InDevBrian/index/Media/Tow_Hitch_Receiver_Report.pdf

# MENG 293 Final Project Technical Document

## BMW E28 Chassis Tow Hitch Receiver

Brian Gill
C0503517

# Table of Contents

Introduction
Purpose
Problem Definition

Summary

Methodology
Measurements Values
Calculated Values
Assumptions
Neglected Factors

Establishing a Baseline
Chassis Strength Minimums
Comparison of Calculated and Measured Values Vehicle Maneuverability Limits

Design
Description
Materials Used
Safety
Model Images and Drawings

Calculations
Deceleration of performance model E28 M5 Deceleration and forces from bumper impact requirements Maximum lateral acceleration
Center of gravity of the chassis
Bumper impact reaction forces
Equations governing hitch forces
Geometry analysis of the bumper shock flange and stress calculations Geometry analysis of the receiver mounting flanges
Stresses due to fully loaded receiver reactions

Future Work

Conclusion

Appendix

Sources

## Introduction

Purpose

This project is meant to promote renewable behaviours through repair and improvement over discard and replacement. To meet this goal, this document describes the development of a solution to enable the BMW e28 chassis to tow trailered loads with a standard ball hitch.

Problem Definition

Original e28 chassis do not come equipped with tow hitch receivers. BMW has previously offered a solution for their European vehicles with a tow mass rating of 1800kg [7]; however, this product is long since discontinued, and was quite intrusive into the trunk area with large bolts and plates to clamp down on the sheet metal, supports stretching from under the taillamps to the tops of the rear strut towers, and a long, complicated install procedure. There are no current aftermarket solutions for these cars. The problem to solve is offering a simple tow hitch receiver that does not modify the chassis and matches the original capacity.

## Summary

This document describes the development of a trailer hitch receiver for the BMW e28 chassis. In the design process analysis was done to determine a minimum strength of the chassis where the receiver is to mount. To determine the minimum strength, calculations were done based on bumper safety standards applicable to this vehicle. Comparing the maximum stresses calculated from towing at rated capacity versus the minimum stresses based on required impact ratings, it was found that the chassis cannot be damaged through towing at maximum capacity. The maximum stresses calculated are based on a handful of assumptions and neglected factors which aim to exaggerate the calculated values to add a layer of safety for the design. Although the chassis won’t be damaged by an 1800kg unbraked load it is not recommended as the maximum deceleration is significantly decreased and could be dangerous in the event of an emergency stop.

## Methodology

Measured Values

Several values needed to be measured for both calculations and design decisions. For the receiver to mate to the existing chassis and fit between the exhaust and bottom of the bumper, the bumper shock absorber flange profile, spacing, and compression distance were measured. To estimate the frictional coefficient of tires, acceleration values at maximum braking were measured. A 3D scan of the chassis was taken to test fit the model in software prior to any assembly.

Calculated Values

The maximum normal acceleration withstood by tires was calculated by recording the velocity where grip would turn to slip through a corner and measuring the radius of the corner at that time. The average deceleration in impact tests was calculated using the displacement of the bumper shock absorbers, and the speed of the impact test. The centre of gravity of the e28 chassis was calculated using the weight distribution, and wheelbase of the car. Equations were developed to determine the maximum straight-line loads on the hitch receiver based on tow mass, road grade, and tire friction limits.

Assumptions

To solve some of the equations developed, assumptions had to be made. The intent of the assumptions made is to increase the estimated forces on the receiver, decrease the chassis rated minimum stresses, or to simplify calculations due to variables that frequently change. The following assumptions were made and held consistent throughout the calculations.

Trailered load is 1800kg mass.
Tongue carries 10% of trailered weight.
Trailer axle to tongue length is 2.45m.
Trailered load is slender and has negligible aerodynamic drag even at high speeds.
Trailered center of mass, tow ball, and vehicle centre of mass are all 0.6m above ground level. Tires have a static frictional coefficient of 0.80.
Trailer axle has a static rolling resistance coefficient of 0.015 [1].
Unpowered, non-braking chassis axles have a static rolling resistance of 0.015 [1]. Deceleration during a crash tests is constant.

Neglected Factors

The purpose of neglecting the following factors is to simplify the calculations and bias them towards higher stresses throughout the system. Neglecting the slight increase of tire friction from wheel slip implies that when towing a load, the driver will act responsibly without slipping any tires.

Aerodynamic drag of the vehicle.
Vehicle weight transfer from brake dive and acceleration squat.
Vehicle weight transfer from transverse loading.
Increased tire friction between 5%- and 20%-wheel slip.
Brake bias and force limits of the braking system.
Acceleration limits from the engine.

## Establishing a Baseline

Chassis and Receiver Strength Minimums

Analysis of the chassis has been done based on the test procedures and requirements for bumpers outlined in [5]. Based on Table 1 and the fact that the North American e28 chassis remained unchanged through all its production starting model year 1981, the minimum bumper impact ratings can be summarized as the chassis remains undamaged following a 5 MPH straight forward front and rear impact or a 3 MPH impact at an angle of 60° from the centre line of the car. The claim to an undamaged chassis follows from a list of definitions written in [5].

The patent describing the rear bumper shock mechanism [2] describes different dimensions from what is measured on the vehicle; however the shape of graph 2 depicting load vs stroke tells us that there is a roughly linear relation between stroke distance and reaction force, which by extension would be seen as a linear increase of deceleration during a crash.

The original tow hitch receiver is commonly rated at 1800kg online [7], although a reputable source has yet to be found. For the European version of this vehicle, a sales brochure translated from Dutch using Duck Duck Go’s translator claims “Permissible trailer weight braked 1400 kg up to max. 12% incline, unbraked 500 kg (trailer weight increase possible, please contact your BMW dealer).” [6]. The mention of possible weight increase supports the claim of a maximum of 1800kg. For the calculations done, the assumption follows an 1800kg load without brakes.

Comparison of Calculated and Measured Values

To ensure the values used as the baseline in the calculations are reasonable, this is a comparison of calculated and measured values using data from multiple sources. In the following text g’s are used in reference to acceleration, 1 g is 9.81m/s²
, and coefficient before g can always be translated as the coefficient of friction between the tire and road surface. Maximum deceleration has been measured at 0.80 g’s in a test vehicle; the performance model e28 m5 manages an average of 0.97 g’s, (1) using data from info sheet 1. Readings from [1] summarize a technical document outlining requirements for braking system performance, of which the greatest deceleration value is 20 ft/s²
(0.62 g’s).
Historical data combined with a measurement from Screenshot 1 provides a lateral acceleration of 0.80 g’s (6). The test vehicle used measured lateral acceleration at 0.60 g’s. Given that [3] is using performance tires and an improved braking system, the slightly higher deceleration is logical.

Chassis Maneuverability Limitations

Every vehicle’s maneuverability is ultimately limited by the tires. Based on 0.80 g’s of acceleration for both straight line and lateral motion, the coefficient of static friction between the tires and the road surface can be
determined as 0.80. That is to say that in any position the net acceleration of the vehicle can not exceed 0.80 g’s. This limit decreases once the trailered load is considered, although the coefficient of friction for the driving vehicles tires does not change. The calculations done to determine the maximum loads present during trailering are in the scenario of perfect braking. Events of large forward and lateral acceleration would be considered irresponsible during towing and as such there are no calculations in this report covering those scenarios.

## Design

Description

The primary goal of the design is to enable users to safely tow any cargo up to 1800kg mass. Beyond reaching this target the design focuses on fixing some issues prevalent in the OEM offered solution from many years ago, these improvements are directed at not impacting the functionality of any safety equipment, not being an eyesore, and not protruding into the trunk area or modifying the chassis in any other way. Featured in the design is safety hoops for safety chains to be installed on, a wire run routing that forces a drip loop into the harness, and a large split to even out the reaction forces and stresses developed during towing. The design is on it’s third revision after the first major change. Future changes are limited to adjusting the split to further improve the load balancing and the designated failure point.

Materials

The goals of specifying materials for this design are primarily to reduce cost, and secondly to prevent corrosion. For all make parts designed the material is mild steel, this is because mild steel is easy to weld, cheap, and strong. All installation hardware should be stainless steel to prevent corrosion. The receiver should be powder coated to withstand the harsh conditions present during road travel.

Safety

For this receiver to have no interference with the original safety equipment, when installed without a tow ball the receiver must not protrude past the distance of an uncompressed bumper. There must be no way for a trailered load of 1800kg or less to damage the chassis. The electrical system to provide power for running, brake, and turn signal lamps must be fully sealed where it leaves the chassis, be properly sleeved to prevent abrasion, and have drip loops to ensure water does not collect in the connectors.

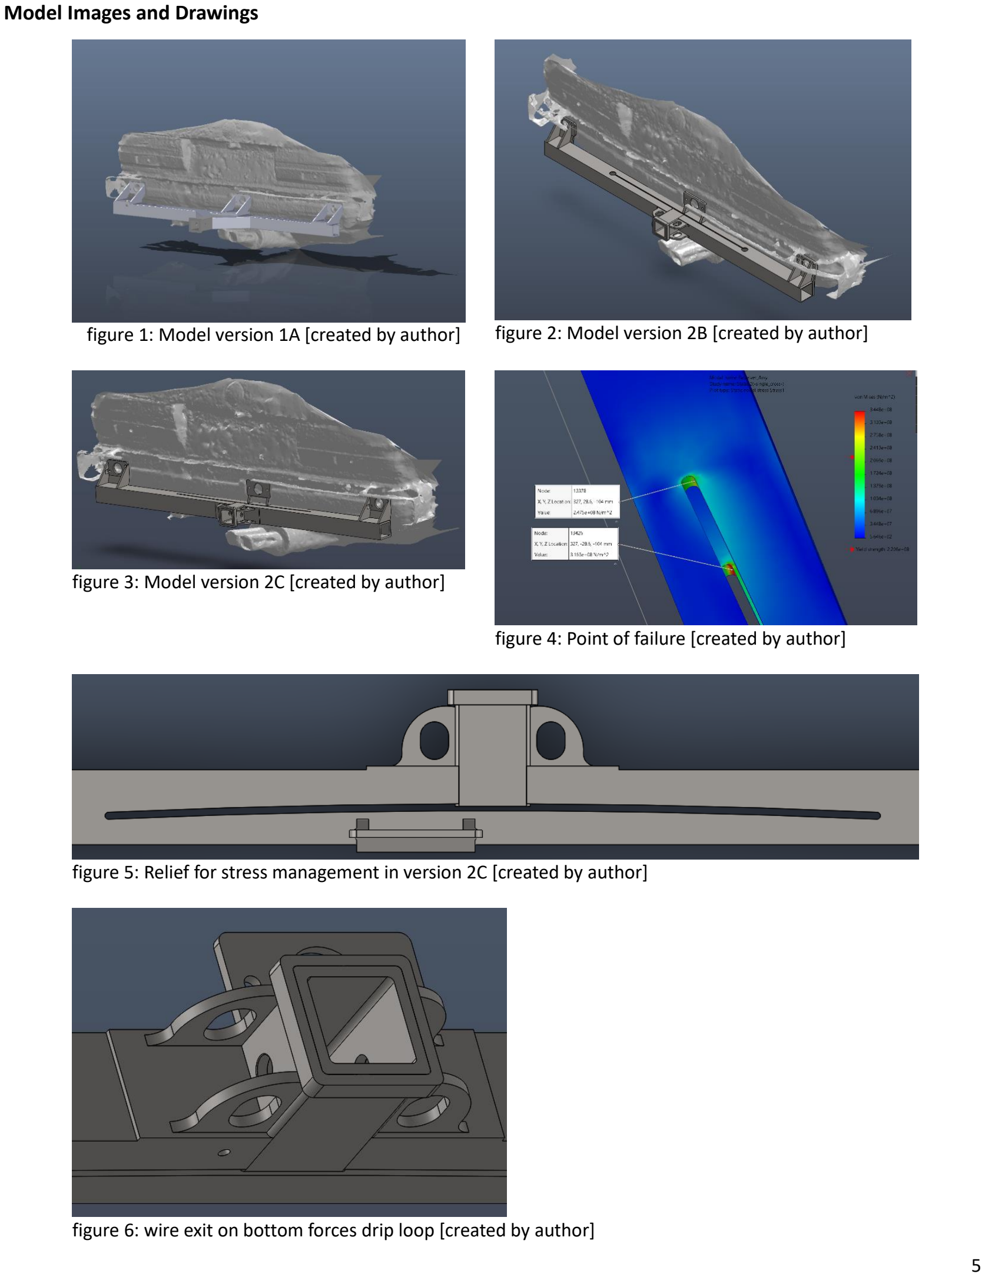
[picture p1: page 6]

Model Images and Drawings

figure 1: Model version 1A [created by author] figure 2: Model version 2B [created by author]

figure 3: Model version 2C [created by author]

figure 4: Point of failure [created by author]

figure 5: Relief for stress management in version 2C [created by author]

figure 6: wire exit on bottom forces drip loop [created by author]

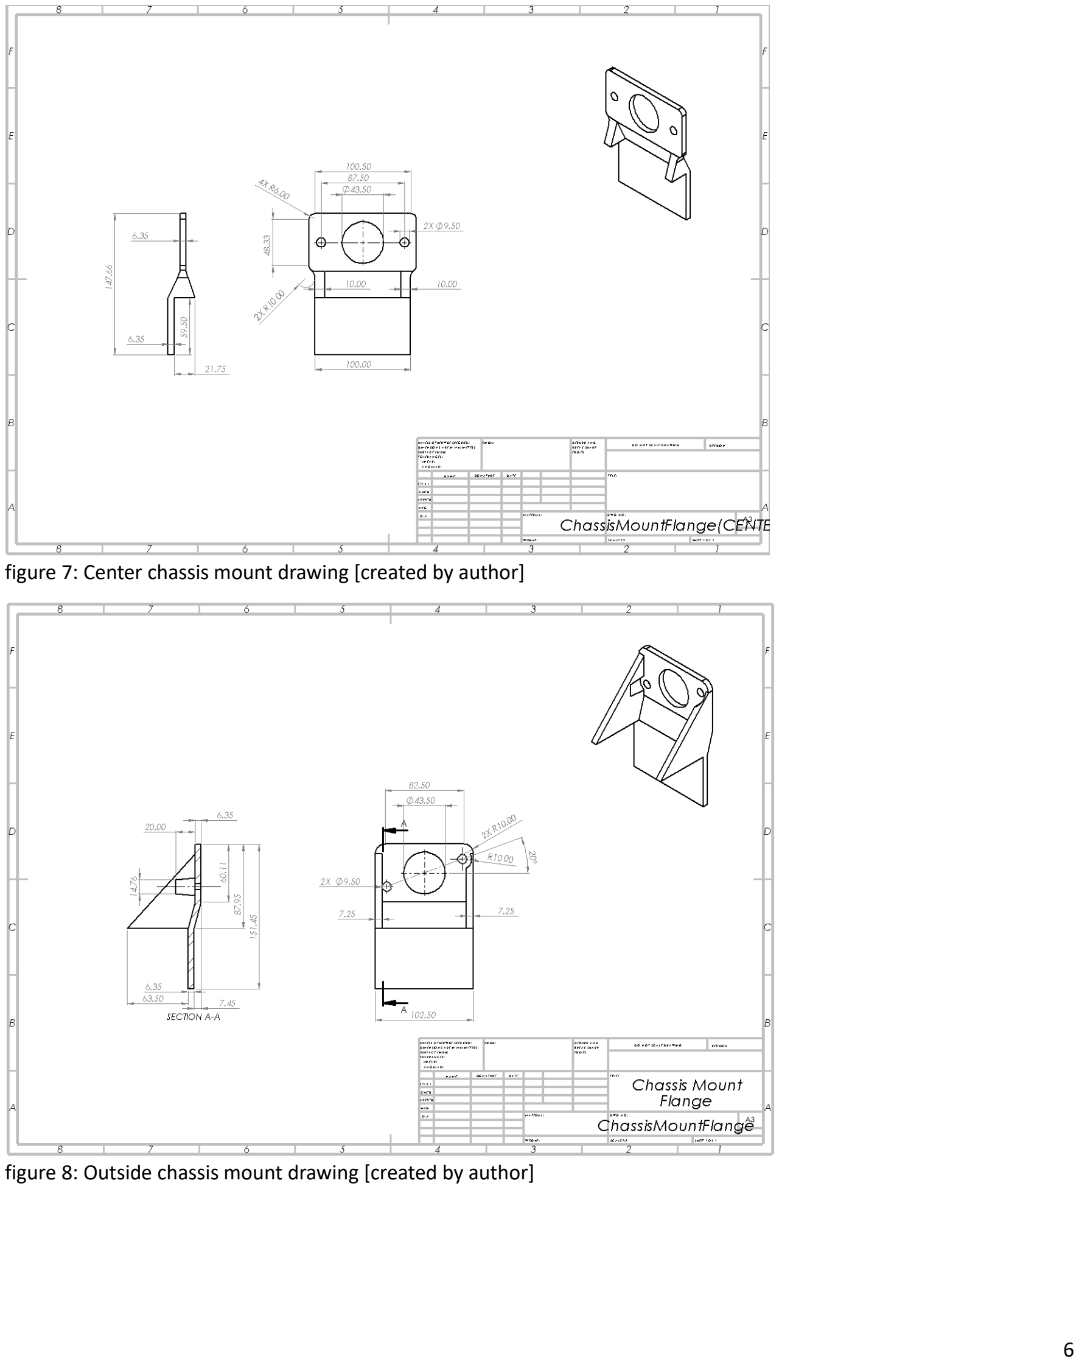
[picture p2: page 7]

figure 7: Center chassis mount drawing [created by author]

figure 8: Outside chassis mount drawing [created by author]

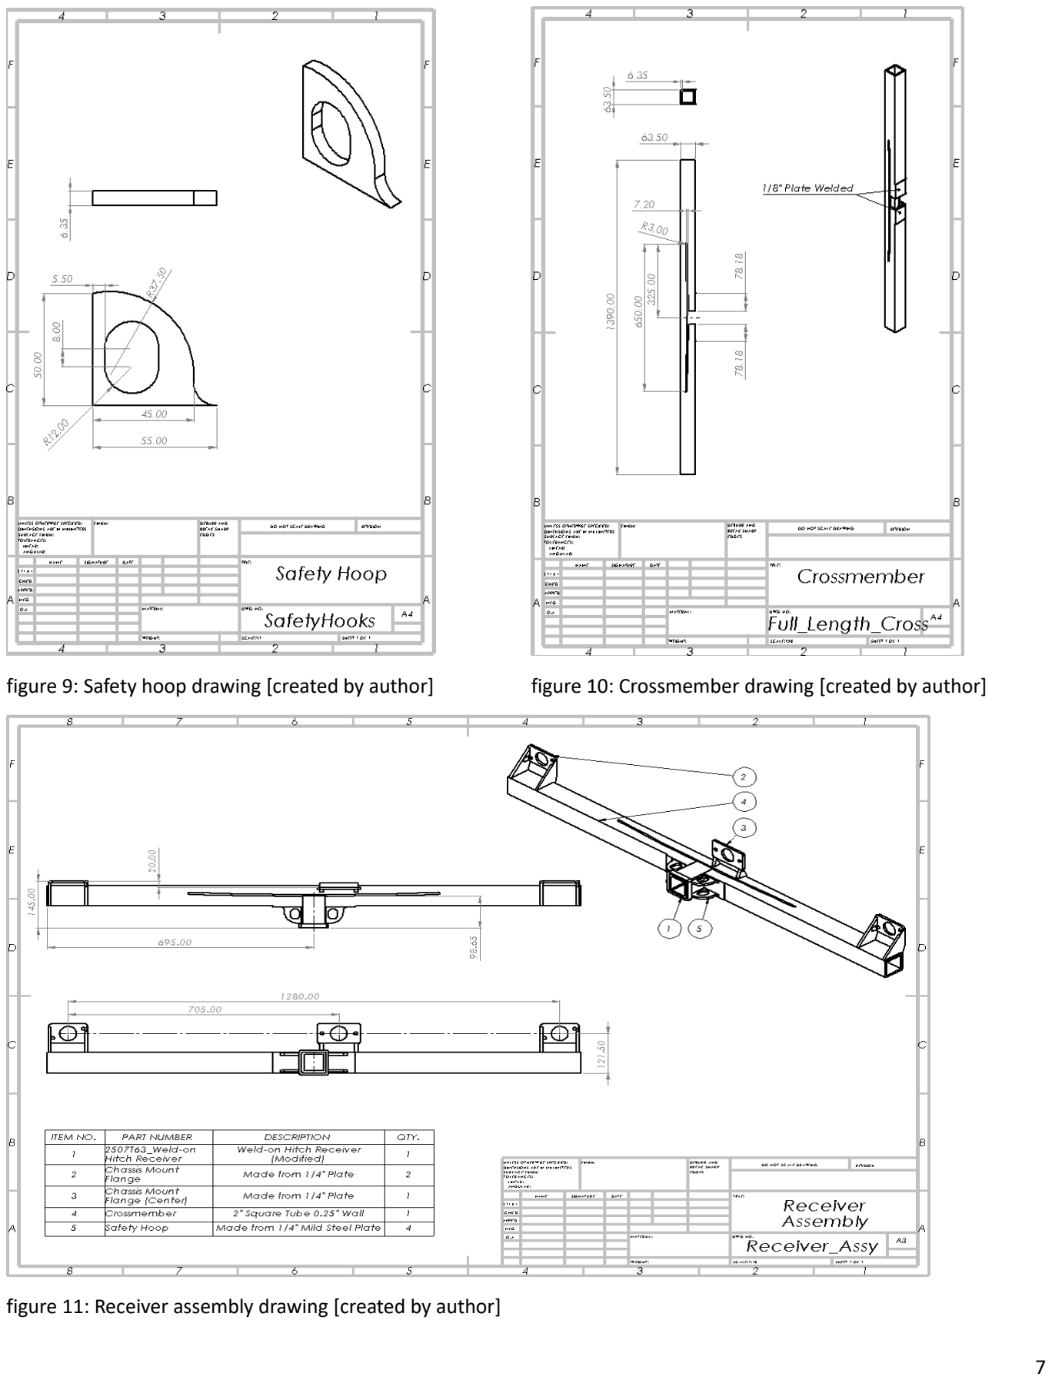
[picture p3: page 8]

figure 9: Safety hoop drawing [created by author] | figure 10: Crossmember drawing [created by author]

figure 11: Receiver assembly drawing [created by author]

## Calculations

### Deceleration of performance model E28 M5:

Maximum Braking Tests from External Source [3]: 100KPH = 27.778 m⁄s , ∆t = 2.9s

a =

∆v
∆t

=

27.778m
s

−0

m
s
2.9s

= 9.579 m
s

2

(1)

### Deceleration and forces from bumper impact requirements:

5 MPH impact: 5MPH = 2.2352 m⁄s , ∆s = 0.075m

a =

VB

2−VA

2

2×∆s

=

0−(2.2352m
s

)

2

2×0.075m

= −33.3075 m
s

2

(2)

Fnet = m × a = 1400kg × 33.3075 m
s
2 = 46630N | (3)

3 MPH corner impact: 3MPH = 1.3411 m⁄s , ∆s = 0.075m

a =

VB

2−VA

2

2×∆s

=

0−(1.3411m
s

)

2

2×0.075m

= −11.9903 m s
2 | (4)

Fnet = m × a = 1400kg × 11.9903 m
s
2 = 16786N | (5)

( inline witℎ tℎe car,÷ cos(30) to get total force = 19,384N )

### Maximum lateral acceleration:

Curvature radius: 50m [8], maximum velocity: 70km/h (19.44m/s)

an =

v

2
r

=

(19.44m
s

)

2

50m

= 7.5617 m
s

2

| (6)

### Center of gravity of the chassis:

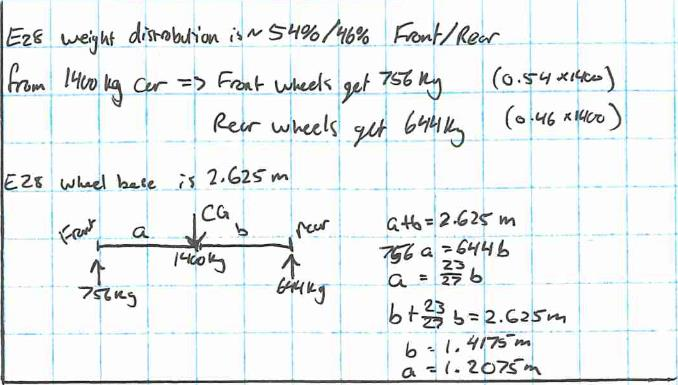
[picture p4: figure]

### Bumper impact reaction forces:

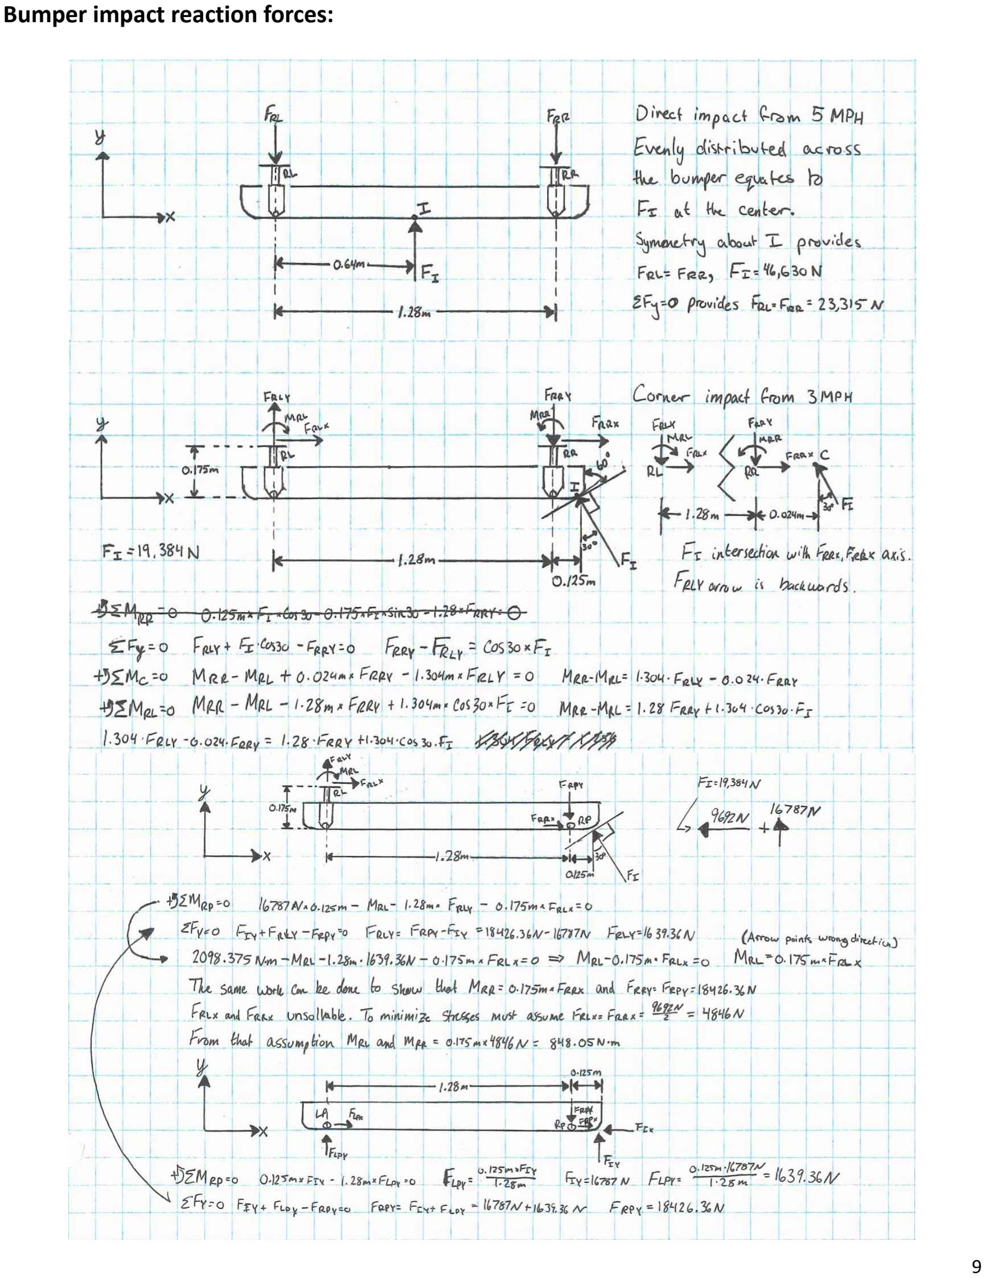
[picture p5: page 10]

### Equations governing hitch forces:

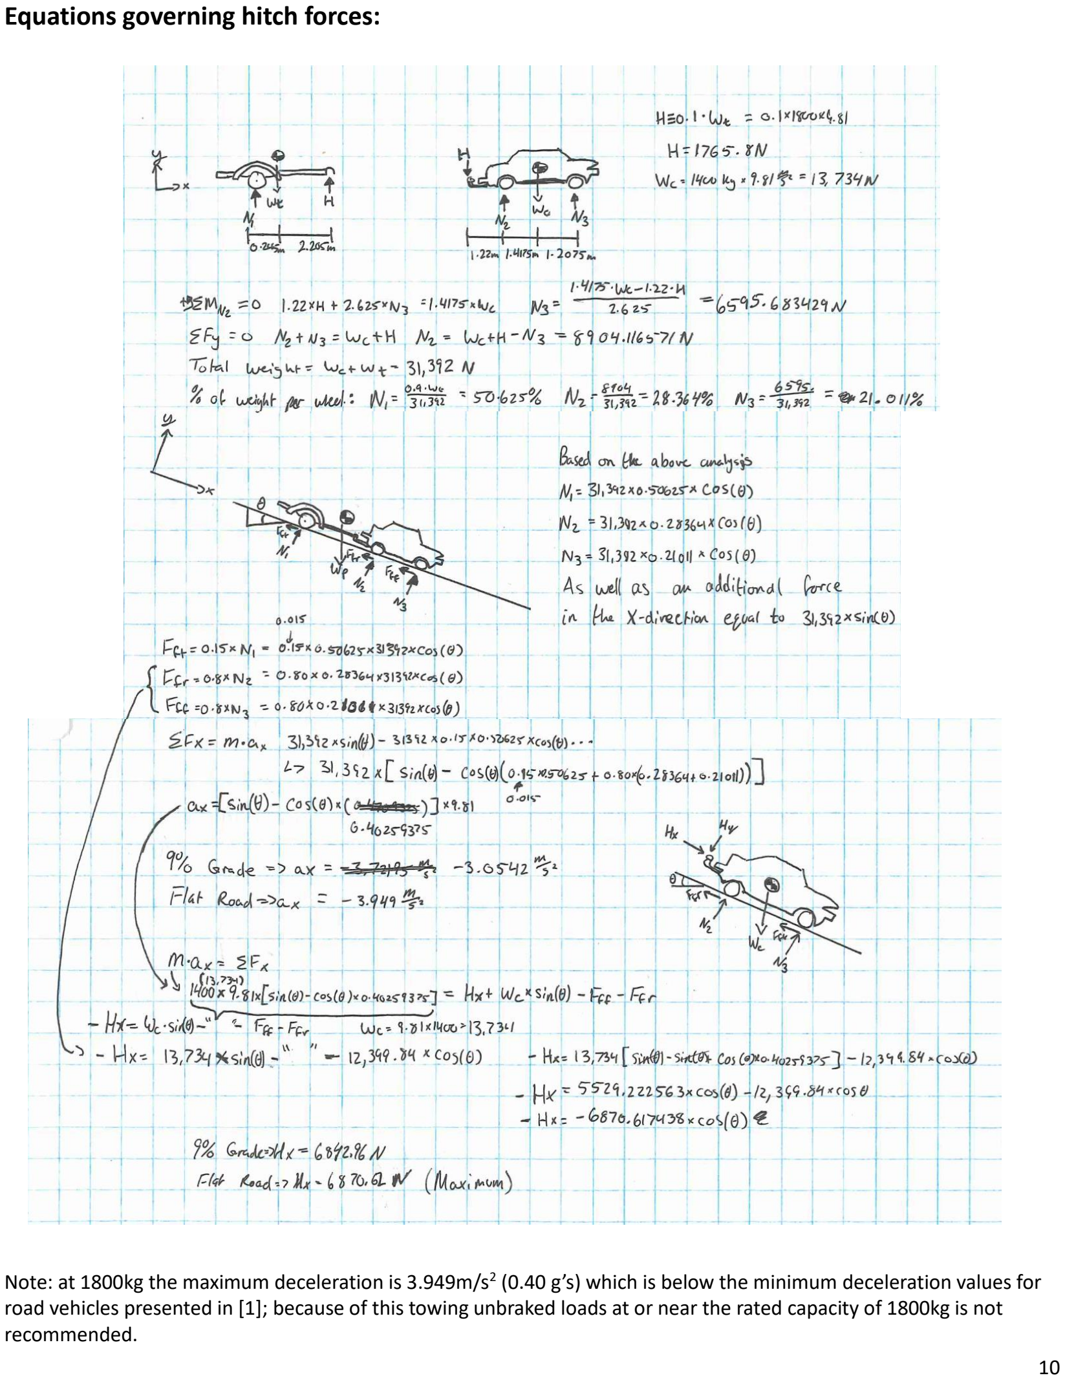
[picture p6: page 11]

Note: at 1800kg the maximum deceleration is 3.949m/s²
(0.40 g’s) which is below the minimum deceleration values for road vehicles presented in [1]; because of this towing unbraked loads at or near the rated capacity of 1800kg is not recommended.

### Geometry analysis of the bumper shock flange and stress calculations:

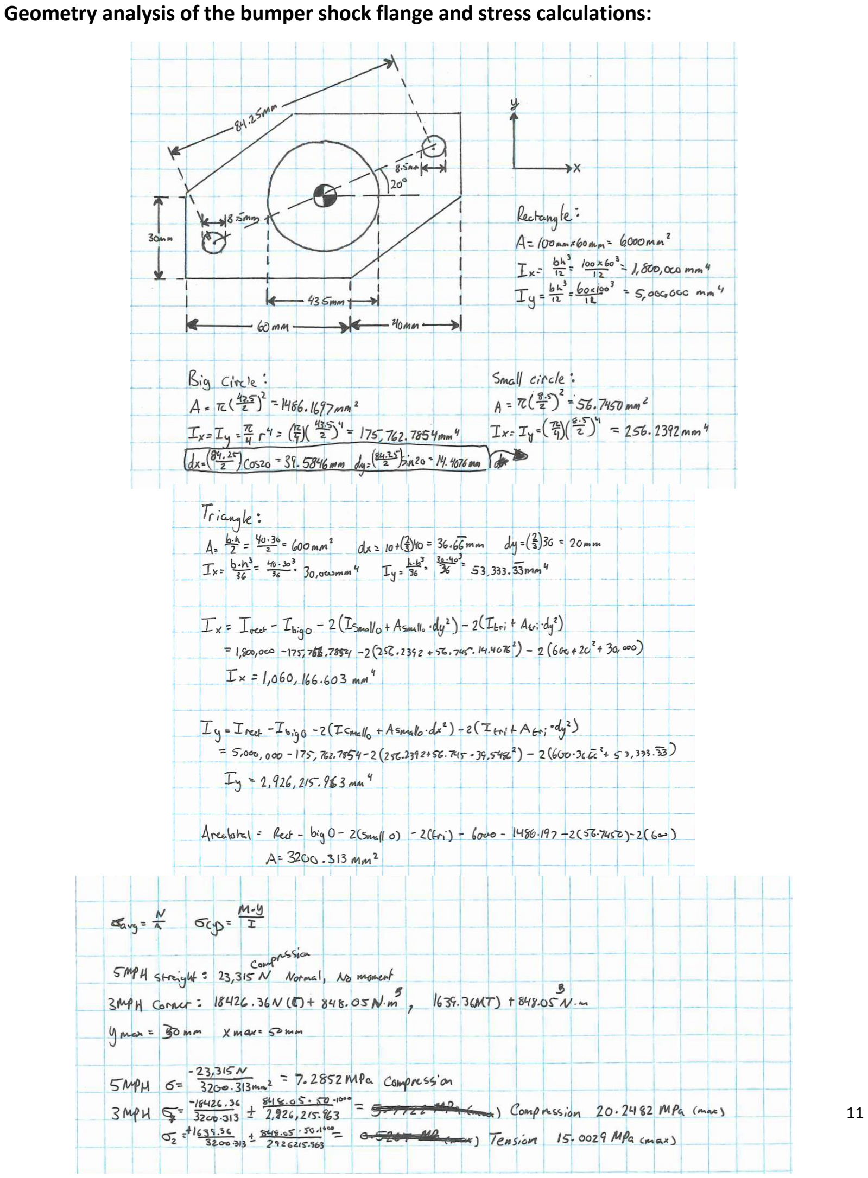
[picture p7: page 12]

### Geometry analysis of the hitch receiver mounting flanges:

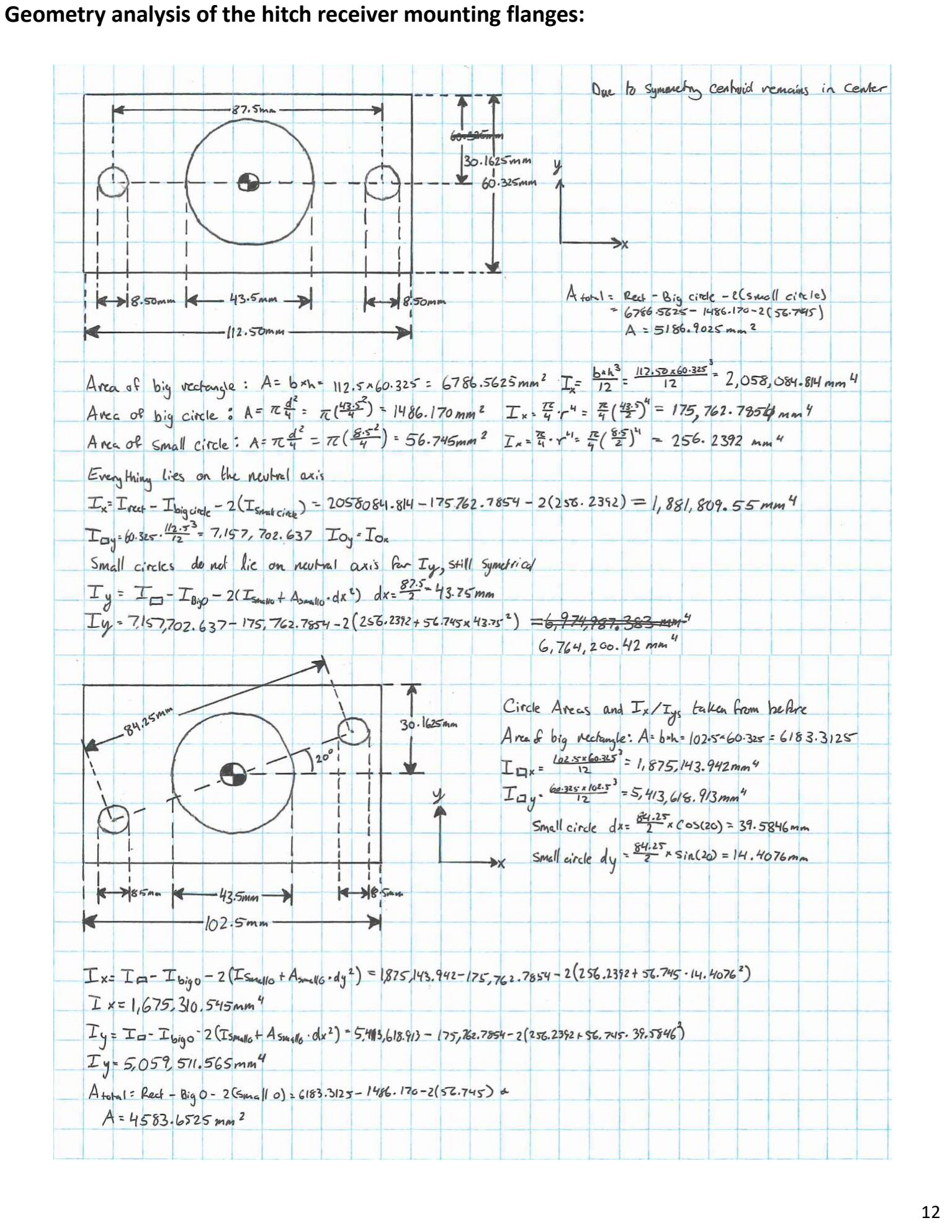
[picture p8: page 13]

### Stresses due to fully loaded receiver reactions:

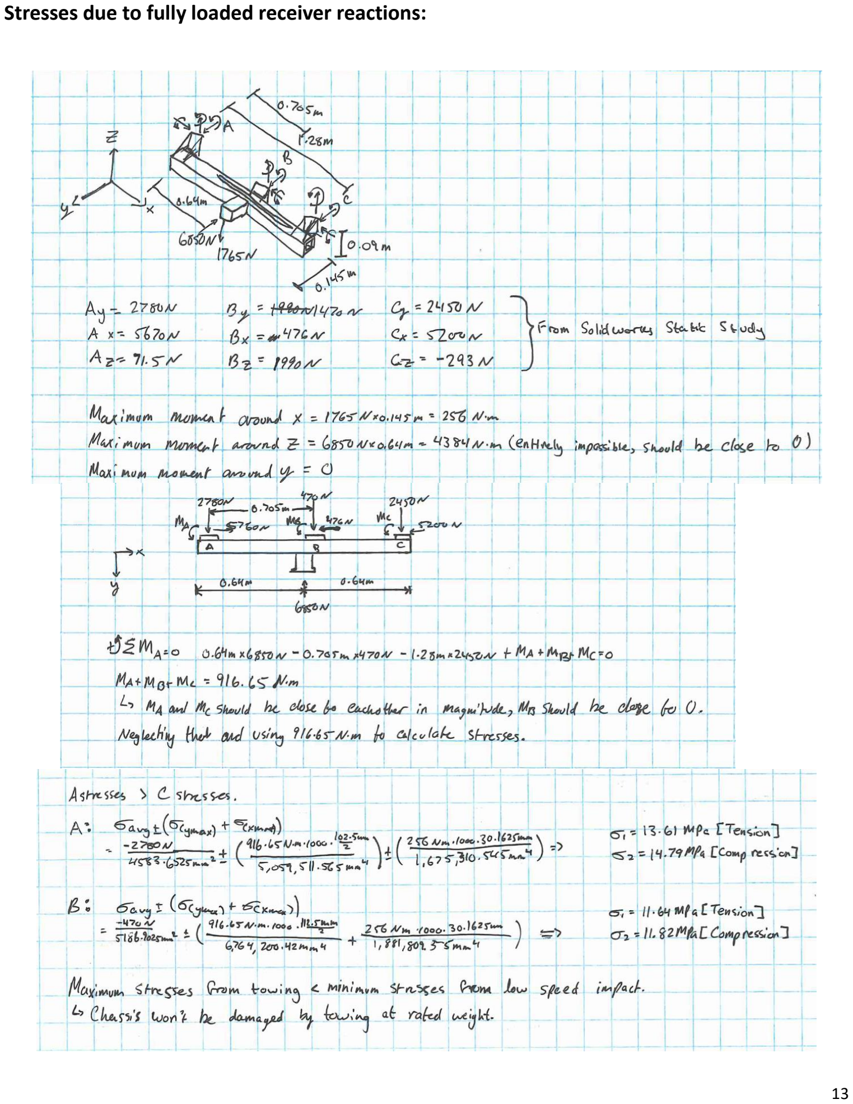
[picture p9: page 14]

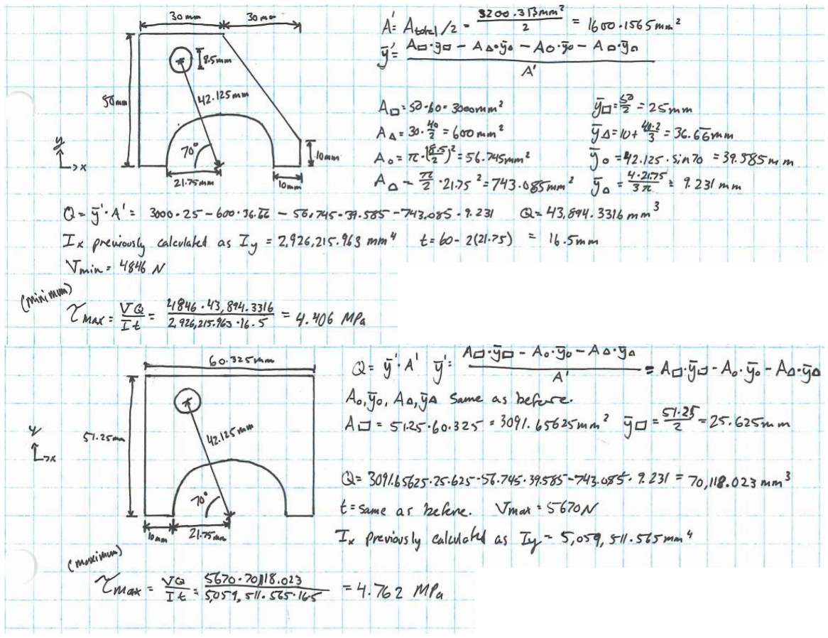
[picture p10: figure]

At the centerline the normal stresses due to bending are zero. The maximum direct normal stress has already been determined. For the 3MPH corner impact, σavg =

N
A

=

18426.36N
3200.313mm² = 5.758MPa. Using the equation τmax in−plane =
√(
σx+σy
2

)

2 + τxy

2 Gives a maximum shear stress of √(
5.758MPa+0MPa
2

)

2 + 4.406MPa² = 5.26MPa. The same analysis is

done with the trailer hitch loads resulting as σavg =

2780N
4583.6525mm² = 0.6065MPa, and τmax in−plane =
√(
0.6065MPa+0MPa
2

)

2 + 4.762MPa² = 4.77MPa. The maximum shear stresses from towing are also less than that of a 3

MPH impact. The shear forces in other directions are minor in comparison and the calculations have been left out of this report.

## Future Work

In continuing this project, the primary focus is to further develop the equations governing the forces acting on the tow ball. These new equations should aim to remove as many assumptions and neglected factors as possible, most importantly brake dive, differences in the height of the centre of mass, changes to the tongue weight and variations in tongue to axle distance. There should also be effort put into calculating the forces present under high lateral acceleration and speed bump/pothole analysis. Lastly, a standardized repair patch to fix corrosion on rear bumper mount flanges should be designed as corrosion in this area is quite standard on these aging cars.

## Conclusion

This project began with the goal of reducing waste through improving the functionality of an existing vehicle; that goal has been proven possible with calculations to back up the claims of a towing capacity at 1800kg unbraked. This document details the assumptions made, calculations performed, completed design and design features, as well as media to showcase the design and how it would look mounted on the vehicle. The receiver is given an 1800kg rating, although unbraked loads will prove difficult to stop at or near this limit. Unbraked loads are recommended to be limited to 500kg to increase safety, this is an arbitrary decision made to match BMW’s towing capacity ratings from [6].

## Appendix

Table 1:
Safety standards described by [4].
Standard | Model Year(s) Applicable | Barrier/Pendulum Speed and Parts Affected
FMVSS 215 | 1973 | 5 mph front and 2 1/2 mph rear impact with barrier. Safety-related parts only.
FMVSS 215 | 1974-1978 | 5 mph front and rear impacts with barrier and pendulum; 3 mph corner impact with pendulum. Safety-related parts only. Pendulum test established bumper height between 16 and 20 inches.
Part 581 incorporating FMVSS 215 | 1979 | As above, plus no damage to exterior surfaces, except bumper facebar and its fasteners.
As above | 1980-1982 | As above, except face bar can have no permanent deviation in contour or position greater than 3/4 inch, and no permanent localized surface deviation greater than 3/8 inch.
As above | 1983 and thereafter | 2.5 mph front and rear impacts with barrier and pendulum; 1.5 mph corner impact with pendulum. No damage to safety-related parts and exterior surfaces, except bumper facebar and fasteners.

Table 2:
Acceleration values recorded during testing, measuring device is an iPhone 11 accelerometer [created by author].
Normal Driving | Maximum Values
Acceleration | 0.2g | Acceleration | 0.5g
Deceleration | 0.3g | Deceleration | 0.8g
Left Turn | 0.2g | Left Turn | 0.6g
Right Turn | 0.2g | Right Turn | 0.6g

Table 3:
Static coefficient of rolling resistance for basic calculations provided by [1].

Surface
Vehicle Type | Concrete | Medium Hard | Sand
Passenger cars | 0.015 | 0.08 | 0.30
Heavy Trucks | 0.012 | 0.06 | 0.25
Tractors | 0.02 | 0.04 | 0.20

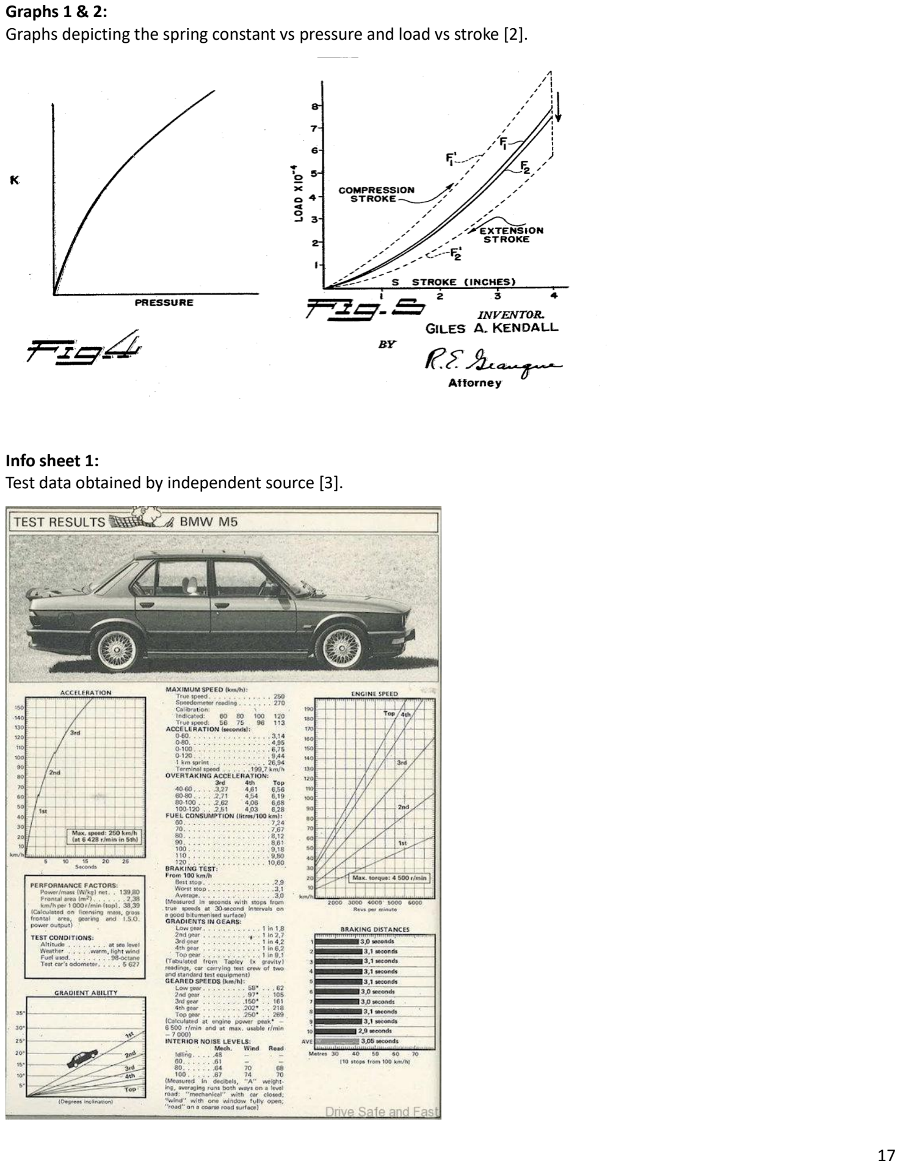
[picture p11: page 18]

Graphs 1 & 2:
Graphs depicting the spring constant vs pressure and load vs stroke [2].

Info sheet 1:
Test data obtained by independent source [3].

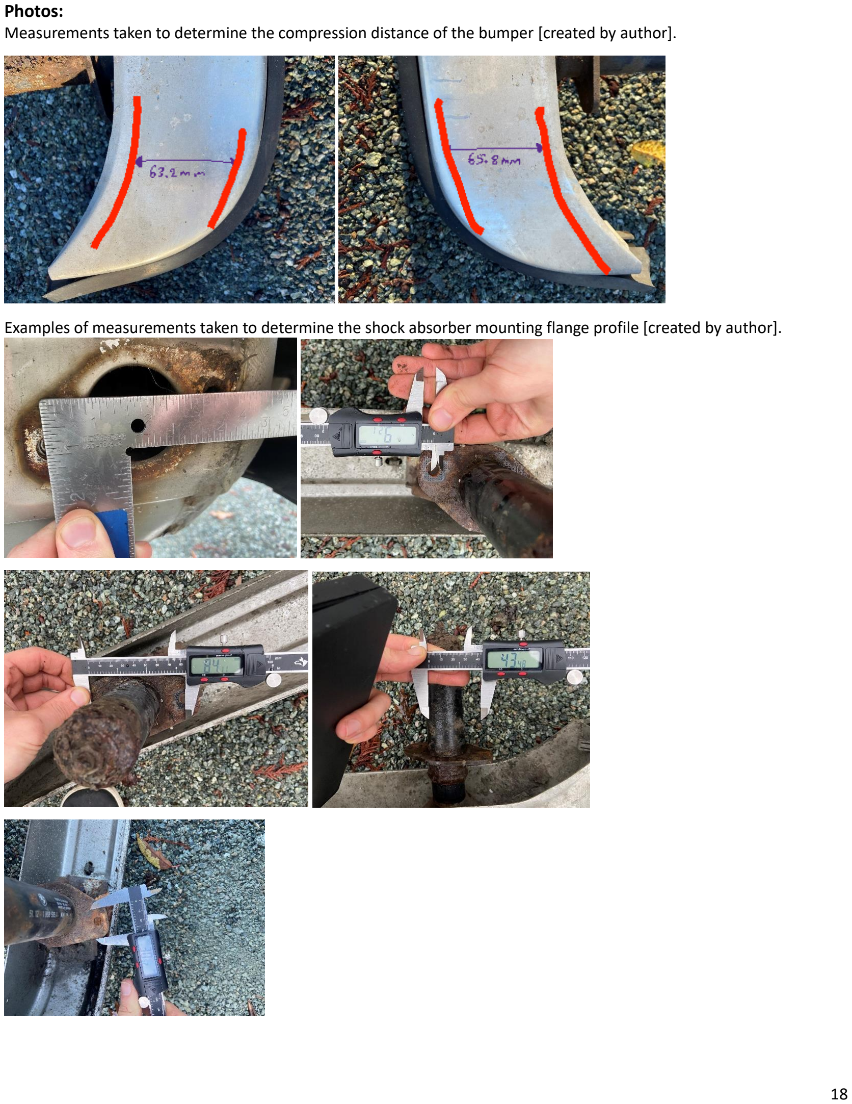
[picture p12: page 19]

Photos:
Measurements taken to determine the compression distance of the bumper [created by author].

Examples of measurements taken to determine the shock absorber mounting flange profile [created by author].

Photo of the shock absorber with a patent number [created by author].

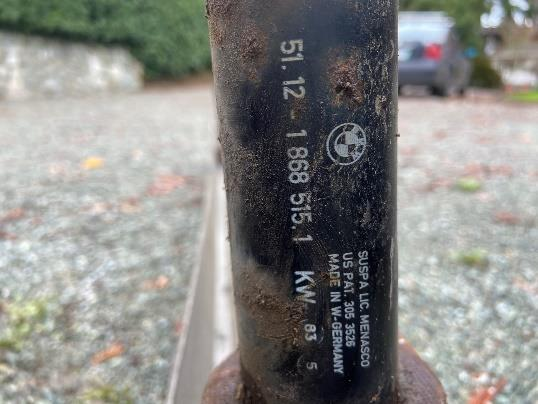
[picture p13: figure]

Measurement taken to determine curvature radius for lateral acceleration calculations [8].

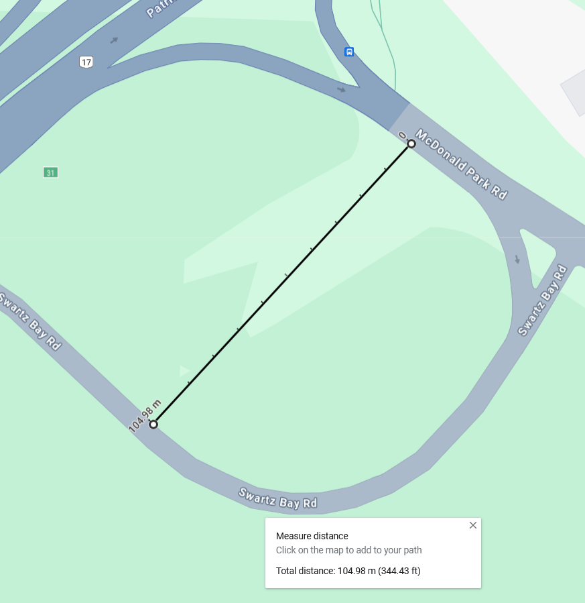
[picture p14: figure]

## References

[1] T. D. Gillespie, Fundamentals of Vehicle Dynamics. Warrendale, PA: Society of Automotive Engineers, 1993, pp. 59, 60, 117.
[2] G. A. Kendall, DAMPERS AND DAMPED SPRINGS, 3053526, Sept 11, 1962. Available: https://image-ppubs.uspto.gov/dirsearch-public/print/downloadPdf/3053526. (https://image-ppubs.uspto.gov/dirsearch-public/print/downloadPdf/3053526) Accessed: Nov. 30, 2023. [Online].
[3] D. S. Fernandez, “BMW E28 M5 Classic Super Sedan Review”, Sept 7 2016. [Online]. Available: https://www.dsf.my/2016/09/bmw-e28-m5-super-sedan-still-the-best/. [Accessed: Nov. 30, 2023].
[4] United States Department of Transportation, National Highway Traffic Safety Administration, An Evaluation of the Bumper Standard-As Modified in 1982. Feb 1987. [Online]. Available: https://crashstats.nhtsa.dot.gov/Api/Public/Publication/807072. [Accessed: Nov. 30, 2023].
[5] United States Department of Transportation, National Highway Traffic Safety Administration, LABORATORY TEST PROCEDURE FOR REGULATION PART 581 Bumper Standard. Apr 25, 1990. [Online]. Available: https://www.nhtsa.gov/sites/nhtsa.gov/files/tp-581-01.pdf. [Accessed: Nov. 30, 2023].
[6] BMW AG, 525e "Eta"en riiplezier: een stap in de richtin van optimal rendement. BMW AG, 1983. [Online]. Available: https://autocatalogarchive.com/wp-content/uploads/2023/03/BMW-Serie-5-1983-NL.pdf. [Accessed: Nov. 30, 2023].
[7] rexmo. (2007, Feb 1). 528e automatic towing capacity? [Msg 8]. Message posted to https://www.mye28.com/viewtopic.php?t=28626. [Accessed: Dec. 5, 2023].
[8] Google. "Google Maps". [Online]. Available: https://www.google.com/maps/@48.6754787,-123.4261371,18.91z?entry=ttu. (https://www.google.com/maps/@48.6754787,-123.4261371,18.91z?entry=ttu) [Accessed: Dec. 5, 2023].
