InDevBrian/index/_e28_downloads/CAMSHAFT_POSITION_SENSOR_BRACKET.SLDPRT

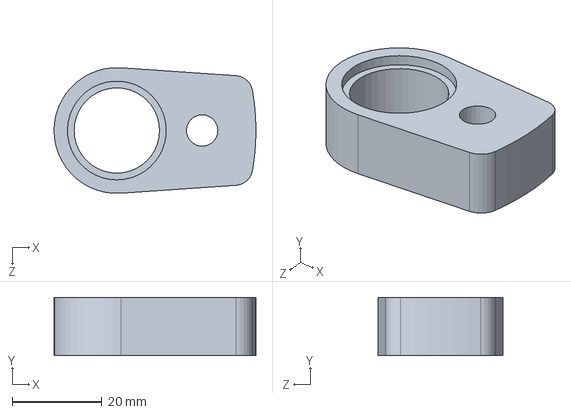
[picture p15: CAD file, 2023-11-02]
_e28_downloads/CAMSHAFT_POSITION_SENSOR_BRACKET.SLDPRT
45.0 x 13.0 x 28.0 mm
