InDevBrian/index/_e28_downloads/M50-M20 TPS Adapter.SLDPRT

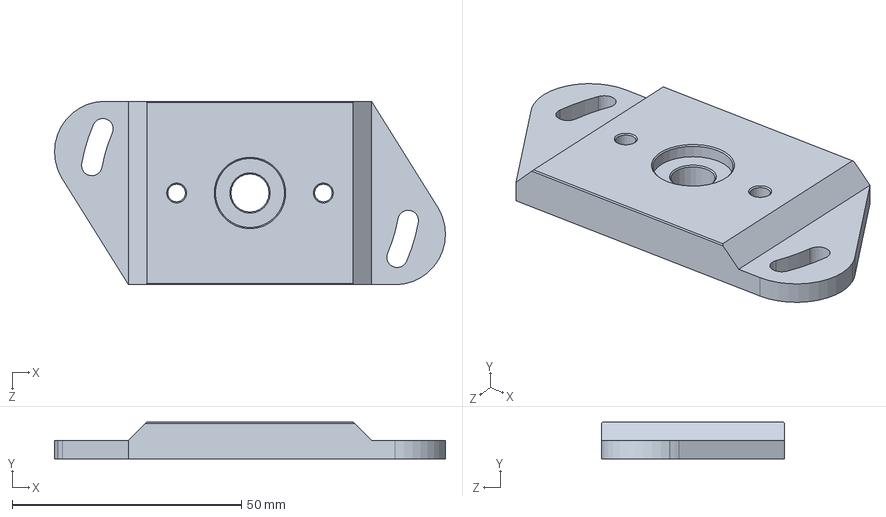
[picture p16: CAD file, 2023-11-02]
_e28_downloads/M50-M20 TPS Adapter.SLDPRT
85.3 x 8.00 x 40.0 mm
