InDevBrian/index/_e28_downloads/DIZZY_COVER.SLDPRT

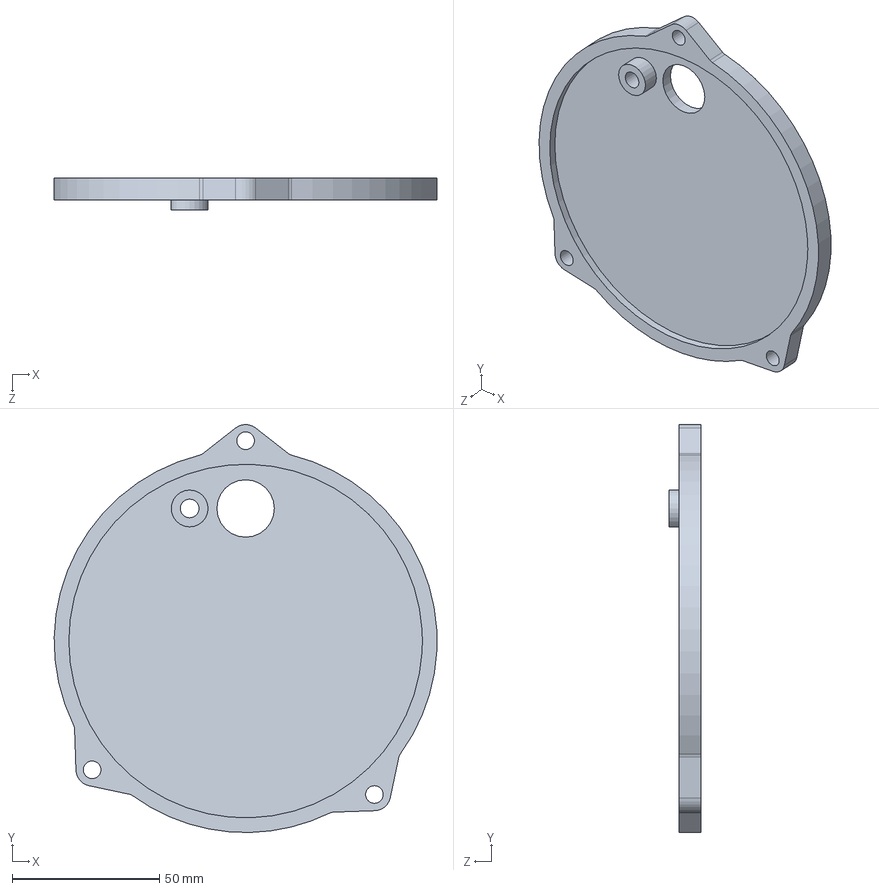
[picture p17: CAD file, 2023-11-02]
_e28_downloads/DIZZY_COVER.SLDPRT
129.9 x 138.5 x 11.0 mm
