InDevBrian/index/_e28_downloads/CAMSHAFT_TOOTH_WHEEL.SLDPRT

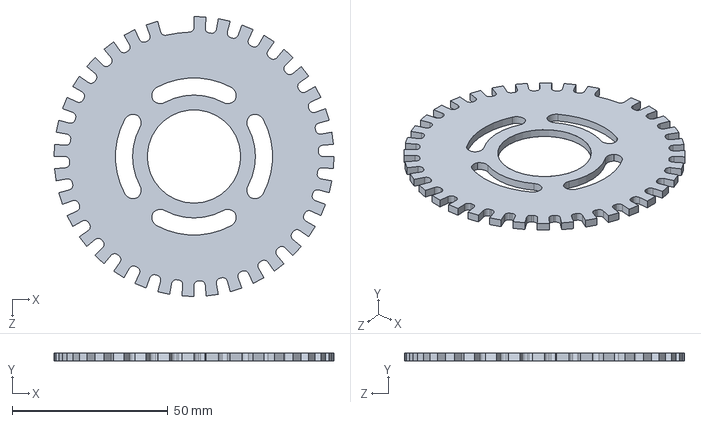
[picture p18: CAD file, 2023-11-02]
_e28_downloads/CAMSHAFT_TOOTH_WHEEL.SLDPRT
90.0 x 2.50 x 90.0 mm
