InDevBrian/index/(list of files, cad)

Other CAD files:
_e28_downloads/CAMSHAFT_POSITION_SENSOR_BRACKET.STL
_e28_downloads/CAMSHAFT_TOOTH_WHEEL.STL
_e28_downloads/DIZZY_COVER.STL
_e28_downloads/M50-M20 TPS Adapter.STL
