InDevBrian/index/(commit log)

2023-09-03 bunch o shit
    remvoe javascript and some css things
    work on changing css to my own stuff
    reorganize landing page
    send links to construction pages
2023-11-02 changes bro
    [CAMSHAFT_POSITION_SENSOR_BRACKET.SLDPRT, CAMSHAFT_POSITION_SENSOR_BRACKET.STL, CAMSHAFT_TOOTH_WHEEL.SLDPRT, CAMSHAFT_TOOTH_WHEEL.STL, DIZZY_COVER.SLDPRT, DIZZY_COVER.STL, M50-M20 TPS Adapter.SLDPRT, M50-M20 TPS Adapter.STL]
